ayuusweetfish/Luminography/hw/Luminography.kicad_pcb

## KiCad design hw/Luminography.kicad_pcb (2024-08-13)

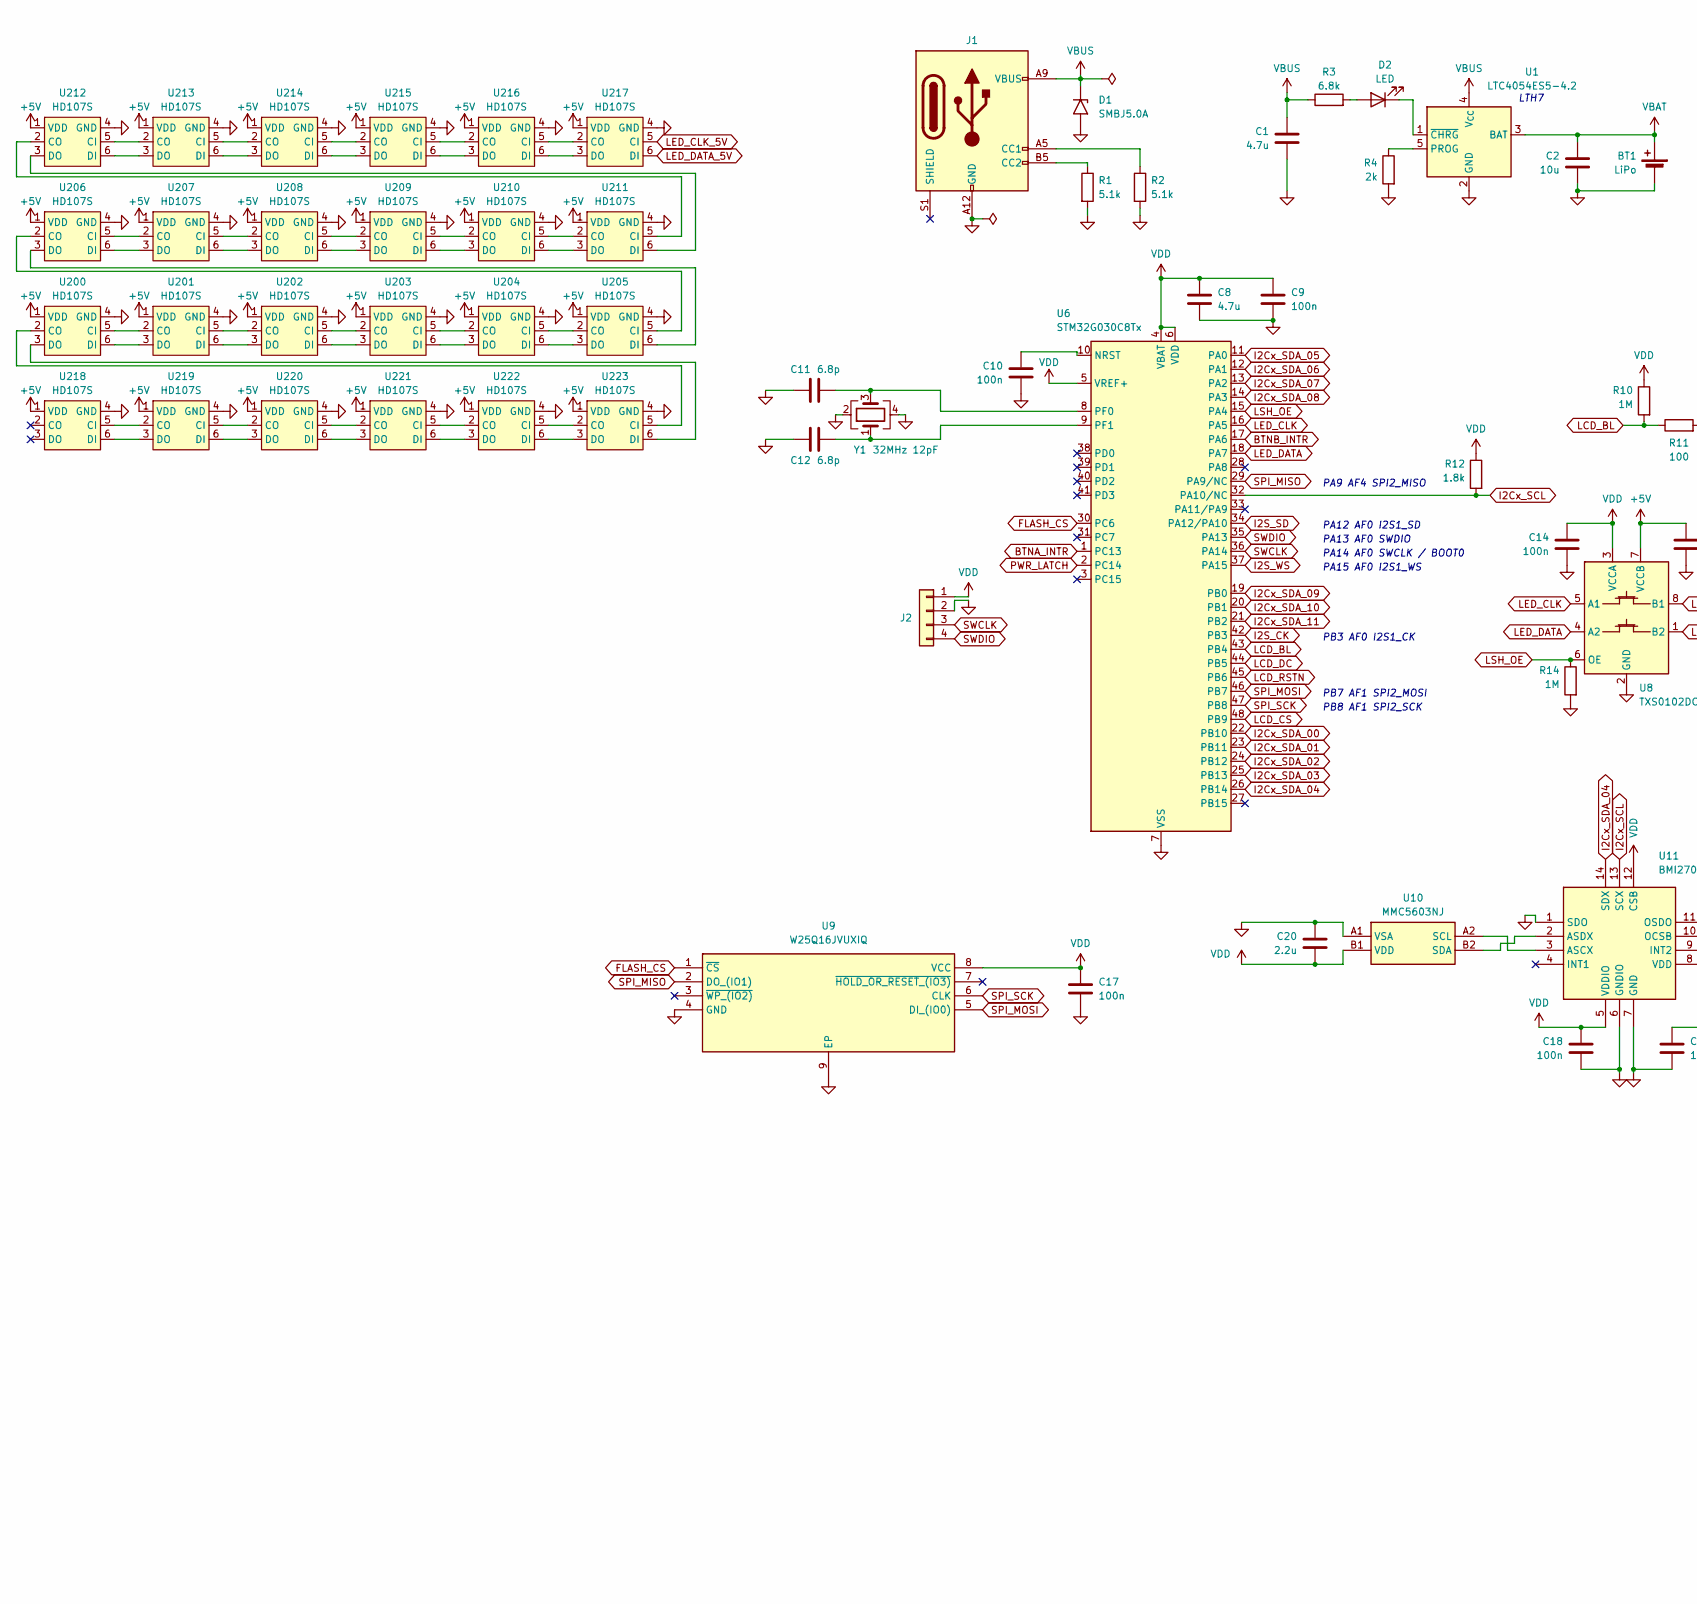
[picture p1: schematic Luminography.kicad_sch, part in row 1, column 1]

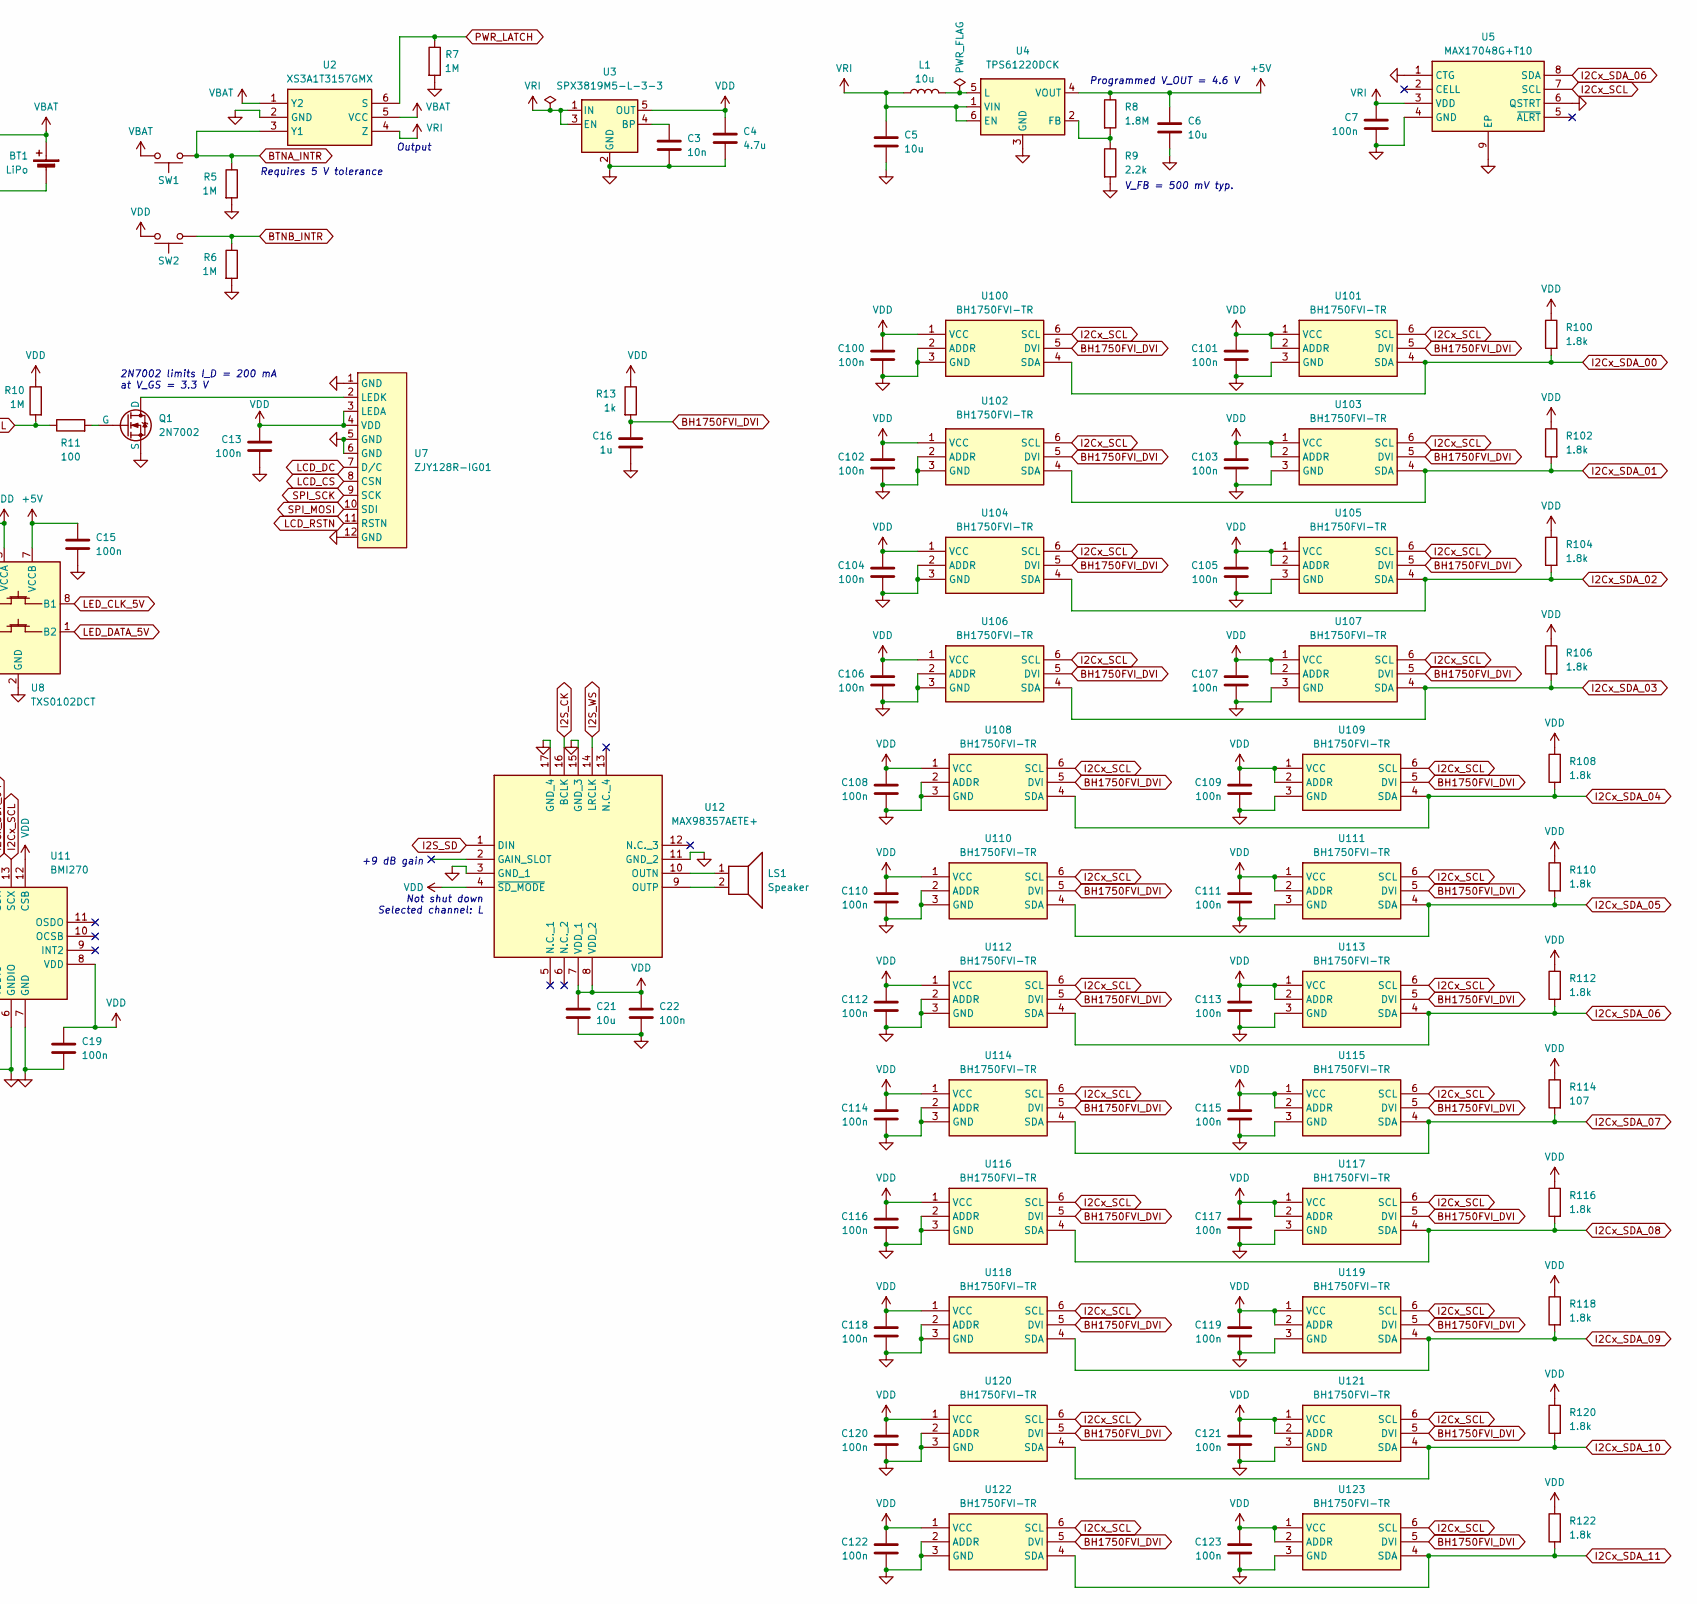
[picture p2: schematic Luminography.kicad_sch, part in row 1, column 2]

Parts:
BT1: LiPo; Pads_1x02_P2.5
C1, C4, C8: 4.7u; C_0402_1005Metric
C2, C5, C6, C21: 10u; C_0402_1005Metric
C3: 10n; C_0402_1005Metric
C7, C9, C10, C13, C14, C15, C17, C18, C19, C22, C100, C101, C102, C103, C104, C105, C106, C107, C108, C109, C110, C111, C112, C113, C114, C115, C116, C117, C118, C119, C120, C121, C122, C123: 100n; C_0402_1005Metric
C11, C12: 6.8p; C_0402_1005Metric
C16: 1u; C_0402_1005Metric
C20: 2.2u; C_0402_1005Metric
D1: SMBJ5.0A; D_SMB
D2: LED; LED_0603_1608Metric
J1: USB_C_Receptacle_PowerOnly_6P; USB_C_Receptacle
J2: Conn_01x04; TestPoints_1x04_P2.0
L1: 10u; L_Sunlord_SWPA252012S
LS1: Speaker; Pads_1x02_P2.5
Q1: 2N7002; SOT-23
R1, R2: 5.1k; R_0402_1005Metric
R3: 6.8k; R_0402_1005Metric
R4: 2k; R_0402_1005Metric
R5, R6, R7, R10, R14: 1M; R_0402_1005Metric
R8: 1.8M; R_0402_1005Metric
R9: 2.2k; R_0402_1005Metric
R11: 100; R_0402_1005Metric
R12, R100, R102, R104, R106, R108, R110, R112, R116, R118, R120, R122: 1.8k; R_0402_1005Metric
R13: 1k; R_0402_1005Metric
R114: 107; R_0402_1005Metric
SW1, SW2: SW_Push; SW_SPST_TL3342
U1: LTC4054ES5-4.2; TSOT-23-5
U2: XS3A1T3157GMX; Manufacturer_Part_Number XS3A1T3157GMX; Mouser Part Number 771-XS3A1T3157GMX
U3: SPX3819M5-L-3-3; SOT-23-5
U4: TPS61220DCK; Texas_R-PDSO-G6
U5: MAX17048G+T10; SON50P200X200X80-9N-D; Manufacturer_Part_Number MAX17048G+T10; Mouser Part Number 700-MAX17048G+T10
U6: STM32G030C8Tx; LQFP-48_7x7mm_P0.5mm
U7: ZJY128R-IG01; FPC_12_P0.7
U8: TXS0102DCT; SSOP-8_2.95x2.8mm_P0.65mm
U9: W25Q16JVUXIQ; SON50P300X200X60-9N; Manufacturer_Part_Number W25Q16JVUXIQ
U10: MMC5603NJ; Manufacturer_Part_Number MMC5603NJ; Mouser Part Number 438-MMC5603NJ
U11: BMI270; QFN50P300X250X87-14N; Manufacturer_Part_Number BMI270; Mouser Part Number 262-BMI270
U12: MAX98357AETE+; QFN50P300X300X80-17N; Manufacturer_Part_Number MAX98357AETE+; Mouser Part Number 700-MAX98357AETE+
U100, U101, U102, U103, U104, U105, U106, U107, U108, U109, U110, U111, U112, U113, U114, U115, U116, U117, U118, U119, U120, U121, U122, U123: BH1750FVI-TR; WSOF6; Manufacturer_Part_Number BH1750FVI-TR; Mouser Part Number 755-BH1750FVI-TR
U200, U201, U202, U203, U204, U205, U206, U207, U208, U209, U210, U211, U212, U213, U214, U215, U216, U217, U218, U219, U220, U221, U222, U223: HD107S; HD107S_2020_6
Y1: 32MHz 12pF; Crystal_SMD_3225-4Pin_3.2x2.5mm

Connections:
+5V: C6.1, C15.1, R8.1, U4.4 (VOUT), U8.7 (VCCB), U200.1 (VDD), U201.1 (VDD), U202.1 (VDD), U203.1 (VDD), U204.1 (VDD), U205.1 (VDD), U206.1 (VDD), U207.1 (VDD), U208.1 (VDD), U209.1 (VDD), U210.1 (VDD), U211.1 (VDD), U212.1 (VDD), U213.1 (VDD), U214.1 (VDD), U215.1 (VDD), U216.1 (VDD), U217.1 (VDD), U218.1 (VDD), U219.1 (VDD), U220.1 (VDD), U221.1 (VDD), U222.1 (VDD), U223.1 (VDD)
BH1750FVI_DVI: C16.1, R13.2, U100.5 (DVI), U101.5 (DVI), U102.5 (DVI), U103.5 (DVI), U104.5 (DVI), U105.5 (DVI), U106.5 (DVI), U107.5 (DVI), U108.5 (DVI), U109.5 (DVI), U110.5 (DVI), U111.5 (DVI), U112.5 (DVI), U113.5 (DVI), U114.5 (DVI), U115.5 (DVI), U116.5 (DVI), U117.5 (DVI), U118.5 (DVI), U119.5 (DVI), U120.5 (DVI), U121.5 (DVI), U122.5 (DVI), U123.5 (DVI)
BTNA_INTR: R5.1, SW1.2, U2.3 (Y1), U6.1 (PC13)
BTNB_INTR: R6.1, SW2.2, U6.17 (PA6)
FLASH_CS: U6.30 (PC6), U9.1 (~CS)
GND: BT1.2 (-), C1.2, C2.2, C3.2, C4.2, C5.2, C6.2, C7.2, C8.2, C9.2, C10.2, C11.1, C12.1, C13.2, C14.2, C15.2, C16.2, C17.1, C18.2, C19.2, C20.1, C21.2, C22.2, C100.2, C101.2, C102.2, C103.2, C104.2, C105.2, C106.2, C107.2, C108.2, C109.2, C110.2, C111.2, C112.2, C113.2, C114.2, C115.2, C116.2, C117.2, C118.2, C119.2, C120.2, C121.2, C122.2, C123.2, D1.2 (A2), J1.A12 (GND), J1.B12 (GND), J2.2, Q1.2 (S), R1.2, R2.2, R4.2, R5.2, R6.2, R7.2, R9.2, R14.2, U1.2 (GND), U2.2 (GND), U3.2 (GND), U4.3 (GND), U5.1 (CTG), U5.4 (GND), U5.6 (QSTRT), U5.9 (EP), U6.7 (VSS), U7.1 (GND), U7.5 (GND), U7.6 (GND), U7.12 (GND), U8.2 (GND), U9.4 (GND), U9.9 (EP), U10.A1 (VSA), U11.1 (SDO), U11.6 (GNDIO), U11.7 (GND), U12.3 (GND_1), U12.11 (GND_2), U12.15 (GND_3), U12.17 (GND_4), U100.2 (ADDR), U100.3 (GND), U101.3 (GND), U102.2 (ADDR), U102.3 (GND), U103.3 (GND), U104.2 (ADDR), U104.3 (GND), U105.3 (GND), U106.2 (ADDR), U106.3 (GND), U107.3 (GND), U108.2 (ADDR), U108.3 (GND), U109.3 (GND), U110.2 (ADDR), U110.3 (GND), U111.3 (GND), U112.2 (ADDR), U112.3 (GND), U113.3 (GND), U114.2 (ADDR), U114.3 (GND), U115.3 (GND), U116.2 (ADDR), U116.3 (GND), U117.3 (GND), U118.2 (ADDR), U118.3 (GND), U119.3 (GND), U120.2 (ADDR), U120.3 (GND), U121.3 (GND), U122.2 (ADDR), U122.3 (GND), U123.3 (GND), U200.4 (GND), U201.4 (GND), U202.4 (GND), U203.4 (GND), U204.4 (GND), U205.4 (GND), U206.4 (GND), U207.4 (GND), U208.4 (GND), U209.4 (GND), U210.4 (GND), U211.4 (GND), U212.4 (GND), U213.4 (GND), U214.4 (GND), U215.4 (GND), U216.4 (GND), U217.4 (GND), U218.4 (GND), U219.4 (GND), U220.4 (GND), U221.4 (GND), U222.4 (GND), U223.4 (GND), Y1.2, Y1.4
I2Cx_SCL: R12.2, U5.7 (SCL), U6.32 (PA10/NC), U11.13 (SCX), U100.6 (SCL), U101.6 (SCL), U102.6 (SCL), U103.6 (SCL), U104.6 (SCL), U105.6 (SCL), U106.6 (SCL), U107.6 (SCL), U108.6 (SCL), U109.6 (SCL), U110.6 (SCL), U111.6 (SCL), U112.6 (SCL), U113.6 (SCL), U114.6 (SCL), U115.6 (SCL), U116.6 (SCL), U117.6 (SCL), U118.6 (SCL), U119.6 (SCL), U120.6 (SCL), U121.6 (SCL), U122.6 (SCL), U123.6 (SCL)
I2Cx_SDA_00: R100.2, U6.22 (PB10), U100.4 (SDA), U101.4 (SDA)
I2Cx_SDA_01: R102.2, U6.23 (PB11), U102.4 (SDA), U103.4 (SDA)
I2Cx_SDA_02: R104.2, U6.24 (PB12), U104.4 (SDA), U105.4 (SDA)
I2Cx_SDA_03: R106.2, U6.25 (PB13), U106.4 (SDA), U107.4 (SDA)
I2Cx_SDA_04: R108.2, U6.26 (PB14), U11.14 (SDX), U108.4 (SDA), U109.4 (SDA)
I2Cx_SDA_05: R110.2, U6.11 (PA0), U110.4 (SDA), U111.4 (SDA)
I2Cx_SDA_06: R112.2, U5.8 (SDA), U6.12 (PA1), U112.4 (SDA), U113.4 (SDA)
I2Cx_SDA_07: R114.2, U6.13 (PA2), U114.4 (SDA), U115.4 (SDA)
I2Cx_SDA_08: R116.2, U6.14 (PA3), U116.4 (SDA), U117.4 (SDA)
I2Cx_SDA_09: R118.2, U6.19 (PB0), U118.4 (SDA), U119.4 (SDA)
I2Cx_SDA_10: R120.2, U6.20 (PB1), U120.4 (SDA), U121.4 (SDA)
I2Cx_SDA_11: R122.2, U6.21 (PB2), U122.4 (SDA), U123.4 (SDA)
I2S_CK: U6.42 (PB3), U12.16 (BCLK)
I2S_SD: U6.34 (PA12/PA10), U12.1 (DIN)
I2S_WS: U6.37 (PA15), U12.14 (LRCLK)
LCD_BL: R10.2, R11.1, U6.43 (PB4)
LCD_CS: U6.48 (PB9), U7.8 (CSN)
LCD_DC: U6.44 (PB5), U7.7 (D/C)
LCD_RSTN: U6.45 (PB6), U7.11 (RSTN)
LED_CLK: U6.16 (PA5), U8.5 (A1)
LED_CLK_5V: U8.8 (B1), U217.5 (CI)
LED_DATA: U6.18 (PA7), U8.4 (A2)
LED_DATA_5V: U8.1 (B2), U217.6 (DI)
LSH_OE: R14.1, U6.15 (PA4), U8.6 (OE)
unnamed: D2.2 (A), R3.2
unnamed: D2.1 (K), U1.1 (~CHRG)
unnamed: J1.A5 (CC1), R2.1
unnamed: J1.B5 (CC2), R1.1
unnamed: Q1.3 (D), U7.2 (LEDK)
unnamed: Q1.1 (G), R11.2
unnamed: R4.1, U1.5 (PROG)
unnamed: C3.1, U3.4 (BP)
unnamed: R8.2, R9.1, U4.2 (FB)
unnamed: L1.2, U4.5 (L)
unnamed: C10.1, U6.10 (NRST)
unnamed: C11.2, U6.8 (PF0), Y1.3
unnamed: C12.2, U6.9 (PF1), Y1.1
unnamed: U10.A2 (SCL), U11.3 (ASCX)
unnamed: U10.B2 (SDA), U11.2 (ASDX)
unnamed: LS1.1, U12.10 (OUTN)
unnamed: LS1.2, U12.9 (OUTP)
unnamed: U200.5 (CI), U201.2 (CO)
unnamed: U200.2 (CO), U223.5 (CI)
unnamed: U200.6 (DI), U201.3 (DO)
unnamed: U200.3 (DO), U223.6 (DI)
unnamed: U201.5 (CI), U202.2 (CO)
unnamed: U201.6 (DI), U202.3 (DO)
unnamed: U202.5 (CI), U203.2 (CO)
unnamed: U202.6 (DI), U203.3 (DO)
unnamed: U203.5 (CI), U204.2 (CO)
unnamed: U203.6 (DI), U204.3 (DO)
unnamed: U204.5 (CI), U205.2 (CO)
unnamed: U204.6 (DI), U205.3 (DO)
unnamed: U205.5 (CI), U206.2 (CO)
unnamed: U205.6 (DI), U206.3 (DO)
unnamed: U206.5 (CI), U207.2 (CO)
unnamed: U206.6 (DI), U207.3 (DO)
unnamed: U207.5 (CI), U208.2 (CO)
unnamed: U207.6 (DI), U208.3 (DO)
unnamed: U208.5 (CI), U209.2 (CO)
unnamed: U208.6 (DI), U209.3 (DO)
unnamed: U209.5 (CI), U210.2 (CO)
unnamed: U209.6 (DI), U210.3 (DO)
unnamed: U210.5 (CI), U211.2 (CO)
unnamed: U210.6 (DI), U211.3 (DO)
unnamed: U211.5 (CI), U212.2 (CO)
unnamed: U211.6 (DI), U212.3 (DO)
unnamed: U212.5 (CI), U213.2 (CO)
unnamed: U212.6 (DI), U213.3 (DO)
unnamed: U213.5 (CI), U214.2 (CO)
unnamed: U213.6 (DI), U214.3 (DO)
unnamed: U214.5 (CI), U215.2 (CO)
unnamed: U214.6 (DI), U215.3 (DO)
unnamed: U215.5 (CI), U216.2 (CO)
unnamed: U215.6 (DI), U216.3 (DO)
unnamed: U216.5 (CI), U217.2 (CO)
unnamed: U216.6 (DI), U217.3 (DO)
unnamed: U218.5 (CI), U219.2 (CO)
unnamed: U218.6 (DI), U219.3 (DO)
unnamed: U219.5 (CI), U220.2 (CO)
unnamed: U219.6 (DI), U220.3 (DO)
unnamed: U220.5 (CI), U221.2 (CO)
unnamed: U220.6 (DI), U221.3 (DO)
unnamed: U221.5 (CI), U222.2 (CO)
unnamed: U221.6 (DI), U222.3 (DO)
unnamed: U222.5 (CI), U223.2 (CO)
unnamed: U222.6 (DI), U223.3 (DO)
PWR_LATCH: R7.1, U2.6 (S), U6.2 (PC14)
SPI_MISO: U6.29 (PA9/NC), U9.2 (DO_(IO1))
SPI_MOSI: U6.46 (PB7), U7.10 (SDI), U9.5 (DI_(IO0))
SPI_SCK: U6.47 (PB8), U7.9 (SCK), U9.6 (CLK)
SWCLK: J2.3, U6.36 (PA14)
SWDIO: J2.4, U6.35 (PA13)
VBAT: BT1.1 (+), C2.1, SW1.1, U1.3 (BAT), U2.1 (Y2), U2.5 (VCC)
VBUS: C1.1, D1.1 (A1), J1.A9 (VBUS), J1.B9 (VBUS), R3.1, U1.4 (V_{CC})
VDD: C4.1, C8.1, C9.1, C13.1, C14.1, C17.2, C18.1, C19.1, C20.2, C21.1, C22.1, C100.1, C101.1, C102.1, C103.1, C104.1, C105.1, C106.1, C107.1, C108.1, C109.1, C110.1, C111.1, C112.1, C113.1, C114.1, C115.1, C116.1, C117.1, C118.1, C119.1, C120.1, C121.1, C122.1, C123.1, J2.1, R10.1, R12.1, R13.1, R100.1, R102.1, R104.1, R106.1, R108.1, R110.1, R112.1, R114.1, R116.1, R118.1, R120.1, R122.1, SW2.1, U3.5 (OUT), U6.4 (VBAT), U6.5 (VREF+), U6.6 (VDD), U7.3 (LEDA), U7.4 (VDD), U8.3 (VCCA), U9.8 (VCC), U10.B1 (VDD), U11.5 (VDDIO), U11.8 (VDD), U11.12 (CSB), U12.4 (~SD_MODE), U12.7 (VDD_1), U12.8 (VDD_2), U100.1 (VCC), U101.1 (VCC), U101.2 (ADDR), U102.1 (VCC), U103.1 (VCC), U103.2 (ADDR), U104.1 (VCC), U105.1 (VCC), U105.2 (ADDR), U106.1 (VCC), U107.1 (VCC), U107.2 (ADDR), U108.1 (VCC), U109.1 (VCC), U109.2 (ADDR), U110.1 (VCC), U111.1 (VCC), U111.2 (ADDR), U112.1 (VCC), U113.1 (VCC), U113.2 (ADDR), U114.1 (VCC), U115.1 (VCC), U115.2 (ADDR), U116.1 (VCC), U117.1 (VCC), U117.2 (ADDR), U118.1 (VCC), U119.1 (VCC), U119.2 (ADDR), U120.1 (VCC), U121.1 (VCC), U121.2 (ADDR), U122.1 (VCC), U123.1 (VCC), U123.2 (ADDR)
VRI: C5.1, C7.1, L1.1, U2.4 (Z), U3.1 (IN), U3.3 (EN), U4.1 (VIN), U4.6 (EN), U5.3 (VDD)

Notes on the sheet:
Output
+9 dB gain
2N7002 limits I_D = 200 mA at V_GS = 3.3 V
PB8 AF1 SPI2_SCK
PB7 AF1 SPI2_MOSI
PA14 AF0 SWCLK / BOOT0
Not shut down Selected channel: L
PA15 AF0 I2S1_WS
Programmed V_OUT = 4.6 V
Requires 5 V tolerance
PA12 AF0 I2S1_SD
PA13 AF0 SWDIO
LTH7
PA9 AF4 SPI2_MISO
V_FB = 500 mV typ.
PB3 AF0 I2S1_CK

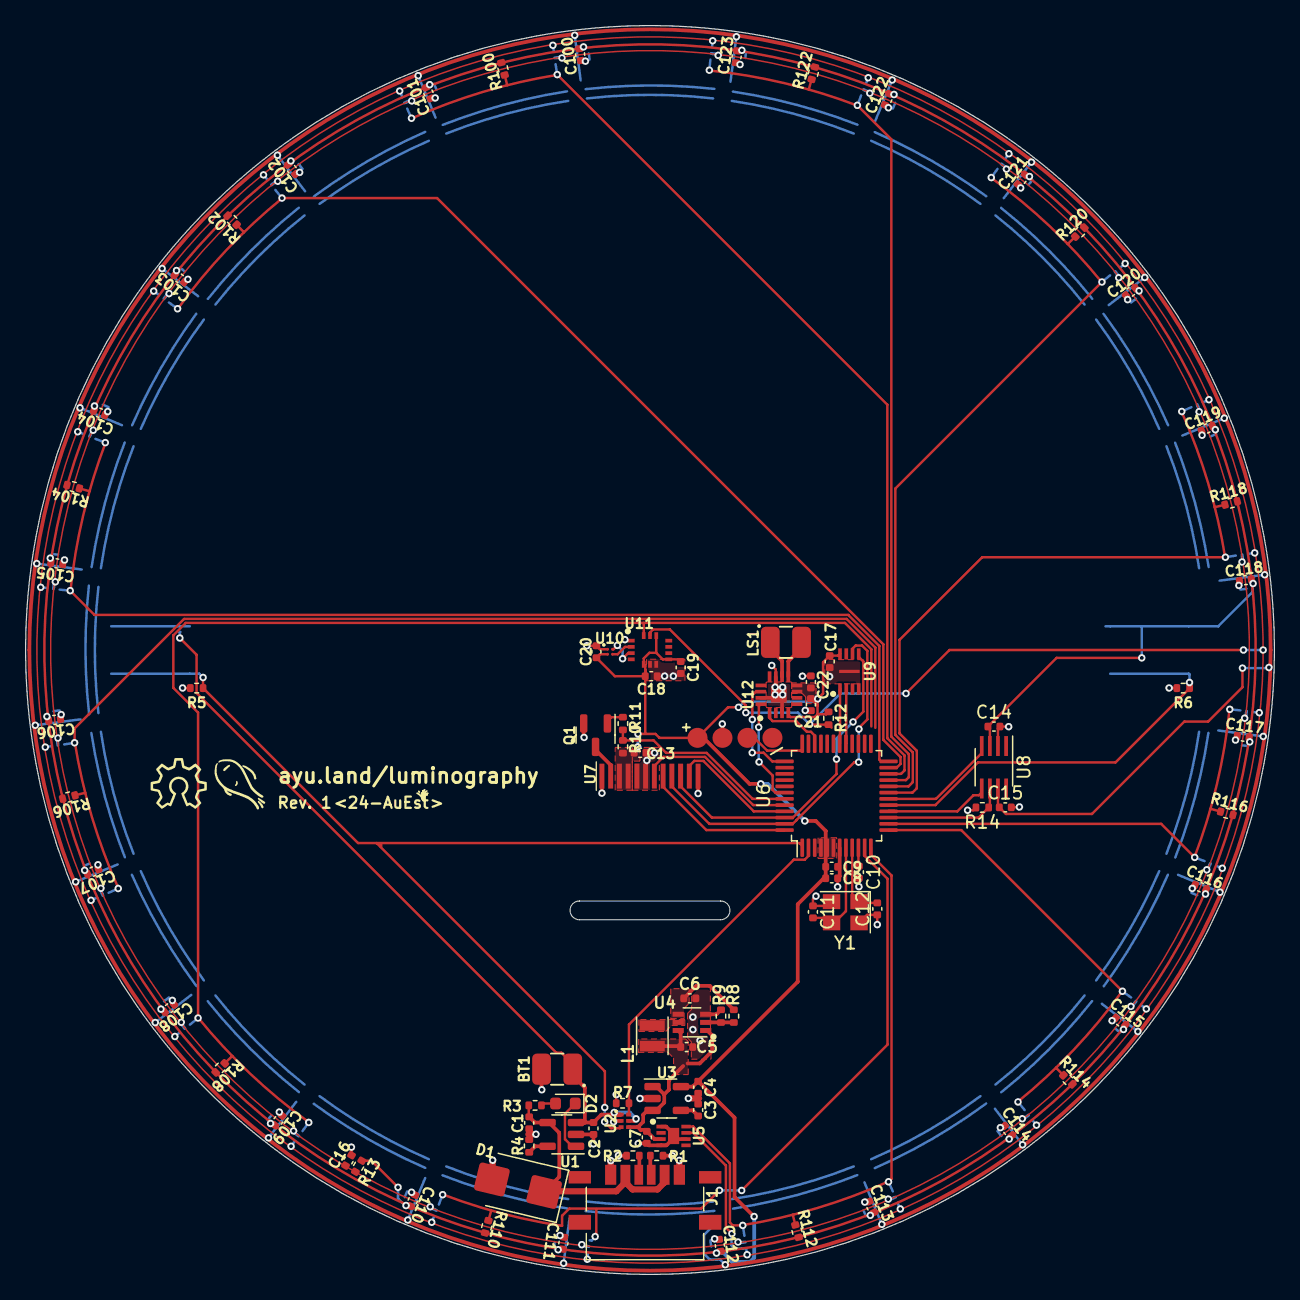
[picture p3: board Luminography.kicad_pcb from above]

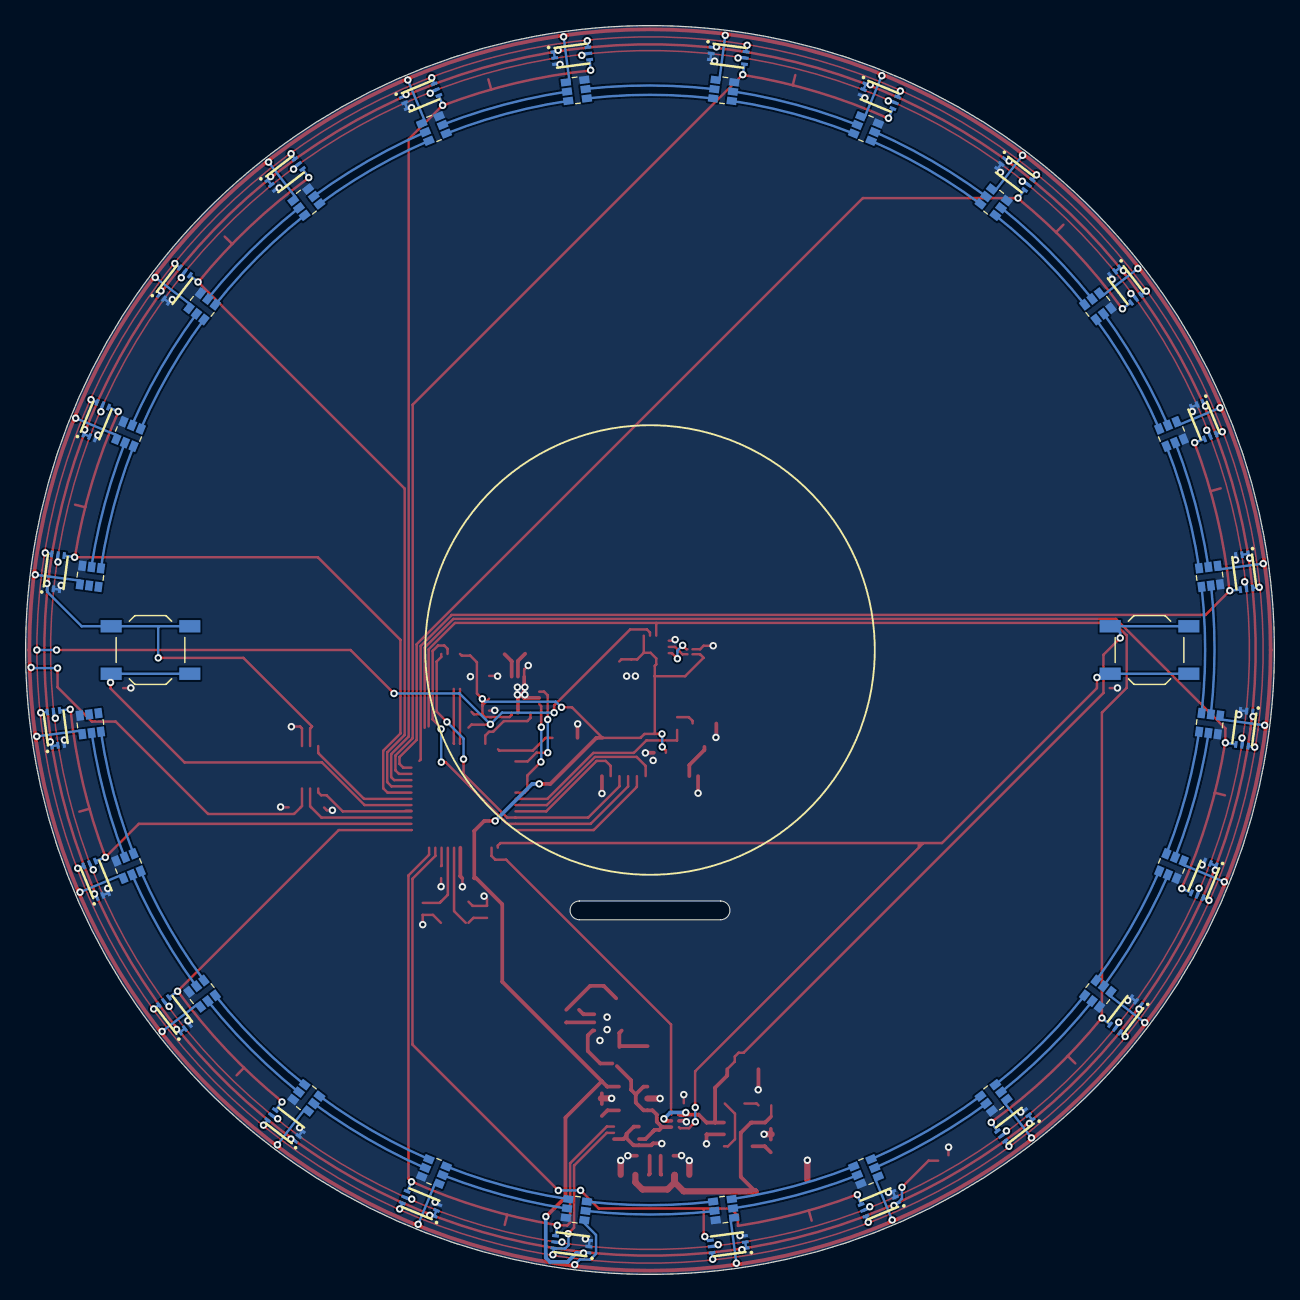
[picture p4: board Luminography.kicad_pcb from below]

Board: 2 copper layers, 100.0 x 100.0 mm, 143 parts (50 on the bottom side), 104 nets.
