ayuusweetfish/Luminography/(commit log)

2024-08-11 🎉 Schematic and libraries
    [Luminography.kicad_pcb, Luminography.kicad_sch]
2024-08-11 Finish sensor array layout
    そんなこと今更叶わない
    [Luminography.kicad_pcb, Luminography.kicad_sch]
2024-08-12 🚧 Layout WIP
    [Luminography.kicad_pcb, Luminography.kicad_sch]
2024-08-12 🚧 Routing WIP
    [Luminography.kicad_pcb, Luminography.kicad_sch]
2024-08-12 🚧 Change USB receptacle to a fully surface-mount model
    [Luminography.kicad_pcb]
2024-08-12 Board design almost done, do later
    [Luminography.kicad_pcb, Luminography.kicad_sch]
2024-08-12 Finish routing
    [Luminography.kicad_pcb, Luminography.kicad_sch]
2024-08-12 🚧 Add LEDs
    [Luminography.kicad_pcb, Luminography.kicad_sch]
2024-08-13 🚧 Finally, add LEDS (board revision WIP)
    [Luminography.kicad_pcb, Luminography.kicad_sch]
2024-08-13 🚧 Maybe finally close to done
    [Luminography.kicad_sch]
2024-08-13 Updates before submission
    [Luminography.kicad_sch]
2024-08-19 Update PCB design file to match actual assembly
    [Luminography.kicad_sch]
2024-08-19 Toggle LED back light
2024-08-19 Fix incorrect resistor value
    [Luminography.kicad_sch]
2024-08-19 Pull up power latch
2024-08-19 Bit bang HD107s LED
2024-08-19 Optimise LED bit-bang
2024-08-20 🚧 SPI (?)
2024-08-20 Clear LED memory at startup to avoid glitching
    [main.c]
2024-08-20 Further flush LEDs
2024-08-20 Read data from I2C bus
2024-08-20 Display light sensor readings on screen
2024-08-20 Read from more sensors
2024-08-20 Read button states
2024-08-21 🚧 I2C parallel read
2024-08-22 🚧 I2C parallel communication
2024-08-22 Finish I2C parallel reading
2024-08-22 Refactor I2C
2024-08-22 Correctly read from IMUs
    [main.c]
2024-08-22 Prevent accidental bus held low on startup
    [main.c]
2024-08-23 Just debug output through LEDs
2024-08-23 Read data from battery monitor
2024-08-23 Read from additional sensors/busses
2024-08-23 Read from sensors of different addresses
2024-08-23 Read more sensors and drive more LEDs
2024-08-24 Align IMU data with device coordinate system
2024-08-24 Change LED patterns according to IMU (🚧 magnetometer)
2024-08-24 🚧 Debugging aid for sensor communication
2024-08-24 Read battery monitor
2024-08-26 Read more sensors, write to more LEDs
2024-08-26 Read all sensors, write to all LEDs
2024-08-26 Full circle LEDs!
2024-08-26 Fix correspondence of LEDs with sensors
    [main.c]
2024-08-27 Finally, calibrated magnetometer?
    Though only translation is used; skew is strange, yielding non-negative eigenvalues for Psi?
2024-08-29 Switch lux meter to continuous low-resolution mode
2024-09-02 Output through DMA'ed I2S
2024-09-03 DMA'ing SPI to LCD
2024-09-03 👩‍💻 Simpler way of toggling audio
2024-09-07 Correctly working screen elements
    [main.c]
2024-09-08 Reducing visible tearing glitches
    [main.c]
2024-09-08 🚧 Text
2024-09-09 Finishing condition check and restart. First playable version 🎉
2024-09-10 Fix scrambled light after the first finish
    [main.c]
